kdp1965/ttsky26d-um-lisa-ttlc/fpga/README.md

# LISA on an FPGA

`arty_a7/` puts the chip's RTL (`src/`, unchanged) on a Digilent Arty
A7-35T (XC7A35T) with Vivado, so programs and the debugger can be tried on
the respin's logic before the silicon is back, at speed and with the real
QSPI Pmod.

What differs from the chip:

- The 32x32 RAM is `src/RAM32.v`, the RTL model of the DFFRAM macro
  (the standard-flow RAM; Vivado makes it distributed RAM or flops).
- The sky130 cells `debug_regs.v` and `lisa_dbg.v` instantiate: the
  `and2_4` is an AND (`fpga_cells.v`); the `dlrtp_1` latches of the static
  debug registers (base addresses, the output and I/O muxes, breakpoints)
  are flops.  `latch2flop.py` copies the two files to `gen/` with each
  latch an `fpga_dlrtp` clocked by the module's `clk`, which captures the
  value during the debug write strobe, as the latch does.
- The project clock comes from the board's 100 MHz oscillator through an
  MMCM (`lisa_arty_clk.v`): 1000 MHz / `CLK_DIV`, 20 = 50 MHz (the demo
  board SDK's default), 25 = 40, 15 = 66.67 (the TT07 chip's ceiling);
  `make CLK_DIV=25`.
- Timing: `lisa_arty_mcp.tcl`, sourced after synthesis, is `src/lisa.sdc`'s
  multi-cycle exceptions on the Vivado netlist (the same register groups,
  found by their RTL names; the build log prints the counts).  Two of the
  SDC's groups are not ported (its pre-decode flop, one-hot on the chip,
  and its divider-operand group, which its register walk resolved to the IX
  low byte and the accumulator), and the debugger's step and skip levels are
  in the continue group with cont_q_r, which the SDC's walk of the cont_q
  net missed.  The build is 50 MHz (`CLK_DIV=20`, the demo board's clock)
  since 2026-10-17 with 0.45 ns of setup slack.  What it took, beyond the
  SDC's groups: the window data as a 3-cycle source (which the SDC has
  too, since the same day), and the BF16 adder's cone into the accumulator
  as a 3-cycle path from everything it takes - 29 LUT levels and 21 ns on
  this fabric, two thirds of it routing, 1.3 ns over at first.  The
  accumulator loads only at the end of the execute state (or the stage
  after), and the adder's inputs are all settled three or more clocks
  before: the latched instruction and the decoded operation flags at the
  end of the fetch state (the operand select and gate), the BF16 registers
  and the accumulator at the end of the previous execute state.  The SDC
  covers the first of these on the chip as its one-hot fetch flop to the
  accumulator; here the state register is binary, so that one is applied
  through the stream's core_i_ready net, the select of the instruction
  mux, whose other sources (a breakpoint's stop) it covers as well.  The
  tightest path now is the divider block's registered operand
  classification through the adder into the accumulator (25 levels).
  40 MHz (`CLK_DIV=25`) closes with 1.5 ns and 125000 baud.

Pins (`lisa_arty.v`, `lisa_arty.xdc`): the three Tiny Tapeout ports are
Pmods in the demo board's order (pins 1-4, 7-10 = bits 0-7): JA `ui_in`
(pulled down, as the RP2040 drives them: baud divisor 0, autobaud on), JB
`uo_out`, JC `uio` (the QSPI Pmod; JB and JC are the high-speed Pmods
without series resistors; uio[4] and uio[6], the debugger's other two rx
candidates, are pulled up), JD unused.  The USB-UART is the debug UART:
its rx and JA pin 4 are ANDed into `ui_in[3]` (both idle high), `uo_out[4]`
drives it and JB pin 7.  The RESET button is the reset, held 65536 clocks
after release and after the MMCM locks.  LEDs: LD4 clock locked, LD5 in
reset, LD6 tx, LD7 rx; LD0 (RGB) is the Ethernet: red a frame received,
green one for us, blue one sent.  SW3 up routes the TTLC's I/O to JA / JB
for a real TTLC Pmod; down (the default) it goes to the chains inside the
FPGA, reached over Ethernet (below).

Build: `make -C fpga/arty_a7` where Vivado is on the PATH, or `make -C
fpga/arty_a7 remote` from a machine without it (copies `src/` and the
directory to the clone on `HOST`, andromeda by default, and runs the build
there; `make remote-prog` programs the board on that machine, `make
remote-log` shows the end of its log).  `build/` has the bitstream,
timing, utilization and DRC reports.  `make lint` runs Verilator over the
whole thing without Vivado.  Running a program (2026-10-17, on andromeda with a Tiny Tapeout QSPI Pmod
on JC): `arty_run.py <file.ihx> [seconds]` loads it into the flash through
the debug port (lisa-tools `lisa_pydb`, which reads Intel HEX since then),
reads back the first words, turns the data cache off, runs it, hands it
the UART and prints what it sends.  hello, test_core, test_printf and
test_irq (rev-2 builds) give lisa_sim --rev2's output.  What it takes:

- Any baud rate from 1.5 Mbaud down since RESPIN item 20 (2026-10-17):
  the scripts default to 460800, the demo board's; 115200, 156250 and
  921600 work too.  Before it the autobaud counted in 32-clock steps, so
  a bit had to be a multiple of 32 clocks: 156250 at 50 MHz, 125000 at
  40 (115200 and 460800 did not lock).
- One serial session per run: opening the port resets the design (the
  Arty's JP2 jumper ties the FTDI's DTR to the RESET line), which clears
  the debug registers and halts the core.
- The data cache off (`w1d0007`): with it on, evicted lines go to a PSRAM
  that is not set up (on the chip testbench there is one), so the globals
  read back wrong while the stack, hot in the cache, survives.
- `l` after the resume gives the program the debug UART.
- The QSPI Pmod's uio[7:4] (WP#, HOLD#, the PSRAM selects) are pulled up
  in the XDC; uio[7:4] are undriven until a program sets the mux, and a
  floating HOLD# held the flash.
- `CACHE=1 arty_run.py ...` runs with the data cache on the Pmod's PSRAM A
  (CS1): `psram_mod` (0x1c bit 10, from ttgf-um-lisa) with the uio mux at
  2 (0x1c = 0x4aa), the cache on CS1 (0x15 = 6), on with the 32K map (0x1d
  = 0x13).  hello, test_core, test_printf, test_irq and the two 32K tests
  (test_bigframe, test_ptroff) pass that way; with psram_mod off
  test_bigframe prints nothing.
- Both selects run quad since 2026-10-18 (Ken: the default, as the chip
  testbench and the demo board): 0x17 = 7 with the cache, 5 without (bits
  1:0 quad per select, 3:2 the flash), 0x18 = 0x66 (6 dummy clocks after
  the EB address on each; the Pmod's flash is a W25Q128JV with its QE bit
  set).  `QUAD=0` is the single-SPI flash of before (0x17 = 6 / 4, 0x18 =
  0x6a), `DUMMY=0x..` another count.  Quad reads of the flash needed
  RESPIN item 21 first: the chip floated the bus during the dummy clocks
  and the flash took its mode bits from whatever the lines did, which on
  the Arty put it into continuous-read mode; the engine drives them 1 now
  (the chip has no pull-ups, so the FPGA has none there either).  Quad on
  both: the debug port's read-back exact, hello, test_core and the TTLC
  loopback pass, and lisa_monitor's calc runs 3 to 5 times faster than
  from single-SPI flash - a float32 add 810 us (2720), a bf16 add on the
  FPU 30 us (100), nine of them 190 us (900).  test_core itself takes
  0.05 s from the UART hand-over to ALL PASSED (0.10 single SPI; the
  serial reads are 0.05 s grained): a run's seconds are the load, the
  serial setup and the capture window, which now ends at the first of
  STOP's markers (ALL PASSED / SOME FAILED) and prints the program's time.

## The TTLC's I/O over Ethernet

The TTLC scans its 48 outputs and 48 inputs through three 74HC595 and
three 74HC165 chains on a Pmod (uo_out[2:0] data, uo_out[5] latch,
uo_out[6] shift clock out; ui_in[6:4] in).  On the Arty the chains are
inside the FPGA (`ttlc_chains_fpga.v`, the chip testbench's model made
synchronous: the scan's shift clock is clk/2 at most, so sampling the pins
every clock sees what the chips see), and their two 48-bit registers are
reached from any host on the LAN through the board's Ethernet PHY
(2026-10-17, Ken's choice over a soft processor: the bridge is ~1000 lines
of plain RTL, no toolchain, and the Mac talks to the board directly):

- `eth_mii_mac.v`: a MAC on the DP83848J's MII (4-bit nibbles at 25 MHz,
  the PHY's own RX_CLK and TX_CLK), received frames into two 2 KB buffers
  used in turn, the frame to send in another, each handed between the
  PHY's clock and the project clock by a four-phase handshake - so all
  the protocol logic runs on the project clock.  FCS checked and appended,
  frames padded to 60 bytes, full duplex only.  A frame that arrives
  while both buffers are held is dropped (the host retries); two buffers
  let frames follow each other by the inter-frame gap, since a parse and
  release take ~2 us.
- `eth_ipstack.v`: one address (192.168.1.200, MAC 02:4c:49:53:41:00,
  parameters of `lisa_arty.v`): answers ARP for it, echoes pings, delivers
  UDP datagrams to port 14500 as a byte stream and sends them from it.  A
  parser walks each received frame a byte a clock (the IP header checksum
  summed on the way) and releases it; a builder writes replies into the
  MAC's buffer, with a pass over the IP header for its checksum first,
  waiting for the transmitter while the parser goes on.  No fragments,
  options or gateway; the UDP checksum is sent as zero and not checked.
- `ttlc_eth_app.v`: the commands.  A datagram is a command byte: `I` with
  six little-endian bytes sets the inputs, `R` reads, `S` subscribes the
  sender to an `E` datagram whenever the outputs change (at most one per
  100 us), `U` ends that.  Every datagram is answered with 20 bytes: type
  (`S`, or `E` for an event), flags (bit 0 subscribed, bit 1 SW3, bits
  7:4 the format's version, 1), microseconds since reset, the outputs,
  the inputs, the events sent.
- `eth_ttlc.v` joins the three; `lisa_arty.v` adds the PHY's 25 MHz
  reference clock (the MMCM's second output through an ODDR), its reset
  (from the MMCM's lock only, 26 ms, so the link survives the RESET
  button and the UART's DTR; no MDIO, the PHY autonegotiates from its
  straps) and LD0.  The XDC constrains the two PHY clocks, marks the three
  clocks asynchronous and gives the MII pins the datasheet's delays.

`test/` is the bridge's own testbench (cocotb on Verilator, `make -C
fpga/arty_a7 test`): the PHY's pins driven with frames built in Python
(ARP, pings of several sizes, UDP commands; the wrong MAC, IP, port and
FCS; back-to-back bursts), the chains scanned by the chip's
`shift_reg_io.v`.  On the board, from andromeda or the Mac:

    ping 192.168.1.200
    ttlc_io.py read                      # or: in <hex48>, watch [quiet s], ping
    arty_ttlc.py ../images/ttlc_loopback.hex   # on andromeda, the serial side

`ttlc_io.py` is the client (a class, `TtlcIo`: `read`, `inputs`,
`subscribe`, `events`, the flash methods below, and a command line);
`arty_ttlc.py` loads a TTLC program (readmemh bytes, as the chip
testbench's flash image) into the Pmod's flash at byte 0x10000 through the
debug port, starts the TTLC (0x1f = 0x100, 0x15 = 4, 0x1b = 0x3cff) and
runs the loopback check over Ethernet.

### The flash over Ethernet (2026-10-18)

The debug UART writes the flash a word at a time with a status poll each,
minutes for a big image.  The bridge can take the QSPI Pmod's bus instead:
`X` holds the chip in reset and drives CS, SCLK and MOSI (uio[0], [3],
[1]), reads MISO (uio[2]) and holds uio[7:4] (HOLD#, WP#, the PSRAM
selects) high; `T <bytes>` is one SPI transaction (CS low, the bytes out
in mode 0 at clk/4, CS high), answered with `T` and the bytes read on
MISO, up to 1024 - a page program is one datagram, a read 1020 bytes; `Y`
gives the bus back and the chip restarts (the bridge also gives it back
5 s after the last `X` or `T`, should the host die).  Status flag bit 2
says the bus is held; the format's version is 2.  The bridge testbench's
test_flash runs the sequence against the chip testbench's flash model.

    ttlc_io.py flash id                       # the JEDEC id, through a continuous-read exit
    ttlc_io.py flash write hello_rev2.ihx     # erase, program, verify (an Intel HEX, readmemh bytes or a binary)
    ttlc_io.py flash write ttlc_loopback.hex 10000
    ttlc_io.py flash read 0 64
    ETH=1 CACHE=1 arty_run.py hello_rev2.ihx  # the image over Ethernet, then the debug port only sets up and runs
    ETH=1 arty_ttlc.py ttlc_loopback.hex

`arty_term.py <file.ihx>` is the live terminal: the image over Ethernet,
the debug port's setup with the data cache on (CACHE=0 for the 128-byte
RAM), the program started and given the UART, then pyserial's miniterm on
the same port (ctrl-] quits).  lisa_monitor built with `sdcc -mlisa
--rev2 --stack-loc 0x7fff` (lisa-tools lisa_monitor/monitor_rev2.ihx,
13396 words, 0.3 s to flash) runs on it: Enter for the banner and
`lisa> `, then help, mr, mw, stack, free, calc, banner (2026-10-18).
`SEND='\rhelp'` on arty_run.py scripts the same a line at a time.

`TtlcIo.flash_write(addr, data)` erases the 64 KB blocks the image
covers, programs it page by page, reads it back and releases the bus;
`load_image(path)` gives the bytes (Intel HEX with gaps as zeros, like
the debug loader).  Open the debug port after the Ethernet write: opening
it resets the design, and the flashing resets the chip too (the debug
registers are set up afresh by the scripts).  On the board (2026-10-18):
hello's 860 bytes and test_core's 4264 bytes each erase, program and
verify in 0.25 s, the debug port reads them back with no mismatch, and
test_core's whole run is 10 s where the UART load alone took two minutes;
the TTLC loopback passes loaded the same way (2.3 s end to end).  The
Pmod's flash answers EF 70 18 (Winbond, 128 Mbit).  2026-10-17: `test/progs/ttlc/ttlc_loopback.hex` copies all
seven patterns from the inputs to the outputs on the board (the first TTLC
run outside simulation, the 12-bit slot format fetched from the flash),
`watch` shows an event per change with the board's timestamps, ping
answers in 0.1 ms from the wired host, a UDP round trip is 2.5 ms from
the Mac over wifi.  At 50 MHz (2026-10-17, the exceptions above) the
same checks pass, hello and test_core with the cache on included.

## Code banks (RESPIN 22)

A program with `__banked` functions (`sdcc -mlisa --rev2`, `#pragma bank n`,
linked `-Wl-bBANKn=<n * 0x8000>`: README-lisa.md "Code banks") has code at
flash byte n * 0x8000 and up, as Intel HEX type-04 records; `ttlc_io.py`'s
`load_image`, `lisa_pydb` and `arty_run.py` take them, so `ETH=1
arty_run.py test_bank_rev2.ihx` runs as any other program (14 of 14 on the
board, 2026-10-18, the bitstream with the bank registers at 50 MHz: setup
slack 0.246 ns).  Mind the TTLC convention of `arty_ttlc.py` / the testbench:
a TTLC program at byte 0x10000 sits where code bank 2 lives, so a banked LISA
program and a TTLC program in one flash need the TTLC base register moved up
(0x1f, in 256-byte units; 0x80000 is above all 16 code banks).
