kdp1965/ttsky26d-um-lisa-ttlc/harden/art/calvin/preview.png

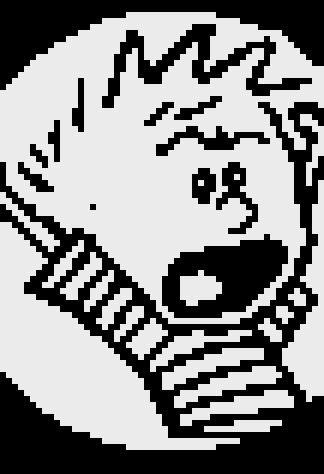
harden/art/calvin/preview.png
