kdp1965/ttsky26d-um-lisa-ttlc/harden/art/calvin/rc4_corner.png

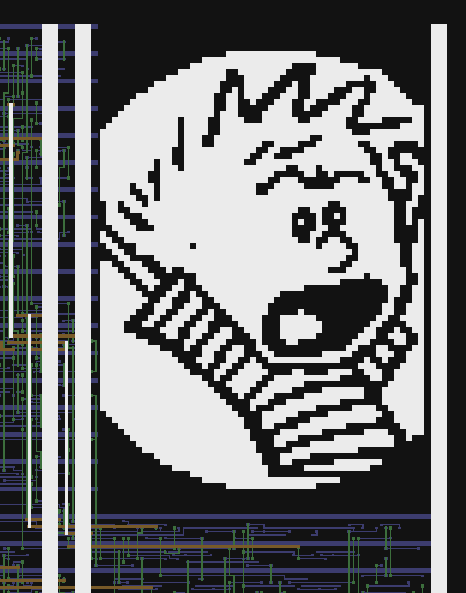
harden/art/calvin/rc4_corner.png
