kdp1965/ttsky26d-um-lisa-ttlc/harden/art/calvin_nocircle/placement_rc18.png

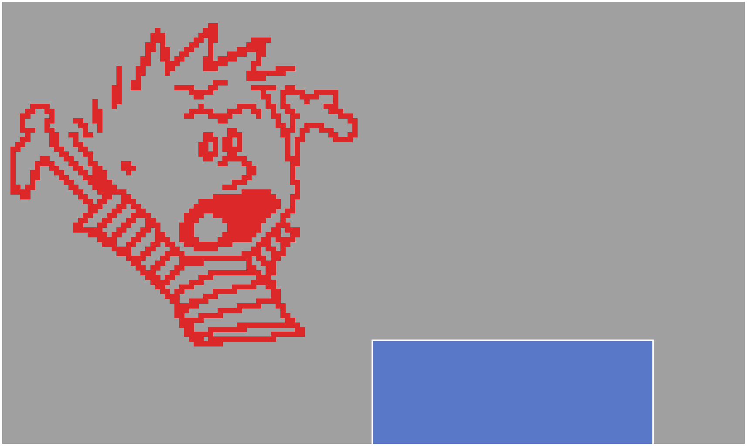
harden/art/calvin_nocircle/placement_rc18.png
