kdp1965/ttsky26d-um-lisa-ttlc/src/lisa_periph.v

/*
==============================================================================
lisa_periph.v:  Little ISA (LISA) peripherals.

Copyright 2024 by Ken Pettit <pettitkd@gmail.com>

Redistribution and use in source and binary forms, with or without
modification, are permitted provided that the following conditions
are met:
1. Redistributions of source code must retain the above copyright
   notice, this list of conditions and the following disclaimer.
2. Redistributions in binary form must reproduce the above copyright
   notice, this list of conditions and the following disclaimer in the
   documentation and/or other materials provided with the distribution.

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
==============================================================================
*/

`define TIMER2
`define WANT_UART2

/*
==========================================================================================
lisa_periph:   A peripheral controller for the lisa core.

Address Map:

   GPIO
   ====
   0x00:       PORT A input
   0x01:       PORT B output
   0x02:       PORT C input / output
   0x03:       PORT C direction (1 = output)
   0x04:       PORT D input   (from TTLC)
   0x05:       PORT E output  (to TTLC)
   0x06:       PORT A INT_CFG0
   0x07:       PORT A INT_CFG1

   TIMER
   =====
   0x08:       Pre Divisor Low
   0x09:       Pre Divisor High
   0x0A:       Divisor Low
   0x0B:       Divisor High
   0x0C:       Control / Status
   0x0D:       Timer tick

   Interrupt
   =========
   0x0E:       Interrupt Enable Register
   0x0F:       Interrupt Status/ACK Register

   UART
   ====
   0x10:       TX/RX register
   0x11:       Status register: bit 0 RX data available, 1 TX buffer empty,
               2 RX overrun (a byte arrived with the 8-byte FIFO full; sticky until it is read empty)
   0x12:       UART2 TX/RX register
   0x13:       UART2 status: bits 0-1 as 0x11, 2 autobaud disable (r/w), 3 RX overrun
   0x1E:       UART2 baud divisor (write): a bit is 32 x (d + 1) clocks
   0x14:       UART interrupt enables

   BANKS (revision 2, RESPIN 22)
   =============================
   0x15:       Code bank  [5:0]: fetches above word 0x4000             (reset 1)
   0x16:       Data bank  [3:0]: IX-relative and debugger accesses above 0x4000 (reset 1)
   0x17:       Stack bank [3:0]: SP-relative accesses above 0x4000     (reset 1)

   TIMER2
   =====
   0x18:       Pre Divisor Low
   0x19:       Pre Divisor High
   0x1A:       Divisor Low
   0x1B:       Divisor High
   0x1C:       Control / Status
   0x1D:       Timer tick

   I2C
   ====
   0x20:       CLOCK PRE div LSB register
   0x21:       CLOCK PRE div MSB register
   0x22:       CTRL
   0x23:       RX
   0x24:       STATUS
   0x25:       TX
   0x26:       CMD

   SPI (RESPIN 29, lisa_spi.v)
   ===
   0x28:       DATA: write sends a byte, read the byte received
   0x29:       CTRL: CS0, CS1, CPOL, CPHA, CLAIM, MISO select [6:5], IE
   0x2A:       DIV: half an SCLK period is DIV + 1 clocks
   0x2B:       STATUS: BUSY, DONE, OWNED, TTLC_WAIT

   TIMER3 (RESPIN 32, lisa_timer3.v): interrupt source 8, vector 9
   ======
   0x30:       PRE: a tick every PRE + 1 clocks
   0x31-0x32:  TOP: the counter runs 0..TOP (reset 0xFFFF)
   0x33-0x34:  CNT (reading the low byte latches the high; a write to the
               low byte loads {the high byte written before, it})
   0x35-0x38:  CMP0, CMP1: PWM0 / PWM1 high while CNT < CMPn
   0x39-0x3C:  CAP0, CAP1: CNT at an edge of ui_in[4] / ui_in[5]
   0x3D:       CTRL: [0] EN, [2:1] PWM1 / PWM0 out, [5:4] CAP0 edge, [7:6] CAP1 edge
   0x3E:       IE: OVF, CMP0, CMP1, CAP0, CAP1; [6:5] PDM0 / PDM1 (RESPIN 36):
               the channel a sigma-delta output of CMPn[7:0] / 256 (CAPn its
               accumulator) instead of an input capture
   0x3F:       STATUS: the same, a 1 written clears

   WS2812B (RESPIN 33, lisa_ws2812.v): the pixels in the TTLC's output flops
   =======
   0x40:       WS_CTRL: [0] EN, [3:1] PIN (uo[0], [1], [2], [5], [6]), [4] IE
   0x41:       WS_STAT: FULL_A, FULL_B, BUSY, DONE, UNDERRUN, NEXT; write sets FULL
   0x42-0x45:  WS_T0H, WS_T1H, WS_TBIT, WS_TRST: the timing in clocks

   CYCLE COUNTER, WATCHDOG (RESPIN 36: lisa_cyccnt.v, lisa_wdt.v; the PDM
   outputs are Timer 3's channels in PDM mode, IE [6:5])
   =============================
   0x48-0x4B:  CYC0..CYC3: a 32-bit count of clocks (a CYC0 read latches 1..3,
               a write to CYC0 clears it)
   0x4C:       WDT_CTRL: [0] EN, [3:1] SCALE
   0x4D:       WDT_KICK: 0xA5 written restarts the count; read: the ticks
   0x4E:       WDT_TIMEOUT: (TIMEOUT + 1) x 2^(16 + SCALE) clocks (reset 255)
   0x4F:       WDT_STAT: [0] WDRST, the last reset was the watchdog's (1 clears)

   TTLC I/O (RESPIN 30, lisa_ttlcio.v)
   ========
   0x2C:       TIDX: the byte of the TTLC's I/O vector, 0-23
   0x2D:       TDATA: byte TIDX (outputs 0-5, inputs 6-11, storage 12-15,
               port_in 16, {RR, 0, 1} 17, 0 18-19, storage 20-23 - RESPIN 31);
               writes to 0-5, 12-15 and 20-23; TIDX + 1
   0x2E:       TCTRL: write [0] START a scan; read BUSY, DONE, PEND, TTLC_WAIT, OWNED

==========================================================================================
*/
module lisa_periph
(
   input                clk,
   input                rst_n,               // includes the watchdog's reset (RESPIN 36)
   input                rst_por_n,           // without it: the watchdog's own
`ifdef WANT_UART2
   input                rst_async_n,
`endif

   // UART access
   input  [6:0]         d_addr,
   input  [7:0]         d_i,
   input                d_periph,
   input                d_we,
   input                d_rd,
   output wire [7:0]    d_o,

   // GPIO
   input  wire [7:0]    porta_in,
   output reg  [7:0]    portb,
   output reg  [3:0]    portc,
   input  wire [3:0]    portc_in,
   output reg  [3:0]    portc_dir,
   input  wire [7:0]    portd_in,
   output reg  [7:0]    porte,

   // The code bank register (RESPIN 22, REV3.md): 7 bits, 128 code banks of
   // 16K words; the core writes it on a jump through IX or a return
   output reg  [6:0]    code_bank,
   input  wire          cb_we,
   input  wire [6:0]    cb_val,

   output wire [8:0]    int_o,               // bit 8: Timer 3 (RESPIN 32), gated by its own IE
   output reg  [7:0]    int_en,
   input  wire          ttlc_int,

   // UART
   output wire [7:0]    uart_tx_d,
   output wire          uart_tx_wr,
   output wire          uart_rx_rd,
   input  wire [7:0]    uart_rx_d,
   input  wire          uart_rx_data_avail,
   input  wire          uart_tx_buf_empty,
   input  wire          uart_rx_overrun,

`ifdef WANT_UART2
   // UART 2
   input  wire          uart2_rx,
   output wire          uart2_tx,
`endif

   // I2C
   input  wire          scl_pad_i,
   output wire          scl_pad_o,
   output wire          scl_padoen_o,
   input  wire          sda_pad_i,
   output wire          sda_pad_o,
   output wire          sda_padoen_o,

   // SPI (RESPIN 29, lisa_spi.v)
   input  wire [3:0]    spi_miso_in,         // {ui_in[7], ui_in[2:0]}
   output wire          spi_sclk,
   output wire          spi_sclk_m3,         // SCLK on the TTLC's pins (moves only while owned)
   output wire          spi_mosi,
   output wire [1:0]    spi_cs_n,
   input  wire          ttlc_scan_req,       // the TTLC wants a scan
   input  wire          ttlc_scan_busy,      // a scan in progress
   output wire          spi_owned,           // the TTLC's mode-3 pins are the SPI's

   // The TTLC's I/O as bytes (RESPIN 30, lisa_ttlcio.v)
   output wire [4:0]    ttlc_idx,
   output wire [7:0]    ttlc_wdata,
   output wire          ttlc_we,
   input  wire [7:0]    ttlc_rdata,
   output wire          ttlc_lisa_start,     // a scan the core started

   // Timer 3 (RESPIN 32, lisa_timer3.v)
   input  wire [1:0]    t3_cap_in,           // ui_in[5:4]
   output wire [1:0]    t3_pwm,              // Timer 3's PWM (or its PDM outputs, RESPIN 36)
   output wire [1:0]    t3_pwm_oe,

   // WS2812B driver (RESPIN 33, lisa_ws2812.v)
   input  wire [47:0]   ws_pixels,           // the TTLC's output_pins: two pixels
   output wire          ws_en,               // WS mode: mux 3's TTLC pins
   output wire [4:0]    ws_pins,             // uo[6], uo[5], uo[2], uo[1], uo[0]
   // ... its DMA through the TTLC's fetch (RESPIN 35)
   input  wire [47:0]   ws_grp,
   input  wire          ws_grp_valid,
   input  wire          ws_fetch_idle,
   input  wire          ws_flush_ack,
   output wire          ws_flush_req,
   output wire          ws_dma_fetch,
   output wire          ws_restart,
   output wire          ws_adv,
   output wire [11:0]   ws_last_grp,
   output wire [15:0]   ws_base,

   // The watchdog (RESPIN 36, lisa_wdt.v): resets the core and the peripherals
   output wire          wdt_reset
);

   reg   [15:0]         ms_count;
   reg   [15:0]         ms_prediv;
   reg   [15:0]         ms_preload;
   reg   [15:0]         ms_timer;
   reg   [7:0]          ms_tick;
   reg                  ms_enable;
   reg                  ms_rollover;
   reg                  uart_tx_ie;
   reg                  uart_rx_ie;
   wire                 uart_req;            // the UART1 request: a level (RESPIN 25)
   wire                 uart2_req;
   
   reg   [5:0]          int_o_r;             // the latched requests (bits 2 / 3 unused: the UARTs are levels)
   wire  [5:0]          int_req;
   reg   [7:0]          porta_last;
   reg   [7:0]          porta_int0;
   reg   [7:0]          porta_int1;
   wire  [1:0]          porta_int_mode[7:0];
   reg   [7:0]          porta_int;
   reg                  ttlc_int_last;

`ifdef TIMER2
   reg   [15:0]         ms2_count;
   reg   [15:0]         ms2_prediv;
   reg   [15:0]         ms2_preload;
   reg   [15:0]         ms2_timer;
   reg   [7:0]          ms2_tick;
   reg                  ms2_enable;
   reg                  ms2_rollover;
`endif

   wire  [3:0]          portc_read;
   reg   [7:0]          d_o_r;
   wire  [7:0]          i2c_d_o;
   wire                 sda_oen_n;
   wire                 scl_oen_n;
   wire                 i2c_irq;
   wire  [7:0]          spi_d_o;
   wire  [7:0]          ttlcio_d_o;
   wire  [7:0]          t3_d_o;
   wire  [7:0]          ws_d_o;
   wire  [7:0]          cyc_d_o;             // RESPIN 36: the cycle counter, the watchdog
   wire  [7:0]          wdt_d_o;
   wire                 ws_ie;
   wire                 ws_irq;
   wire                 t3_irq;
   wire                 spi_xfer_busy;
   wire                 spi_irq;

`ifdef WANT_UART2
   // UART
   wire [7:0]    uart2_tx_d;
   wire          uart2_tx_wr;
   wire          uart2_rx_rd;
   wire [7:0]    uart2_rx_d;
   wire          uart2_rx_data_avail;
   wire          uart2_tx_buf_empty;
   wire          uart2_rx_overrun;
   wire          uart2_brg_wr;
   wire [7:0]    uart2_brg_d;
   reg           uart2_autobaud_disable;
   reg           uart2_tx_ie;
   reg           uart2_rx_ie;
`endif

   // 0x2E's TTLC_WAIT bit, a clock late: ttlc_scan_req is the ICU's FLAG_O,
   // a falling-edge flop, and read through d_o it was a half-clock path into
   // the core (RESPIN 38)
   reg           ttlc_wait_r;
   always @(posedge clk)
      ttlc_wait_r <= rst_n && ttlc_scan_req && spi_owned;

   always @(posedge clk)
   begin
      if (~rst_n)
      begin
         porta_last   <= 8'h00;
         porta_int0   <= 8'h00;
         porta_int1   <= 8'h00;
         portb        <= 8'h00;
         portc        <= 4'h00;
         porte        <= 8'h00;
         portc_dir    <= 4'h0;
         code_bank    <= 7'h1;
         ms_prediv    <= 16'd29494;
         ms_count     <= 16'h0;
         ms_timer     <= 16'h0;
         ms_preload   <= 16'h0;
         ms_tick      <= 8'h0;
         ms_enable    <= 1'h0;
         ms_rollover  <= 1'b0;
         int_o_r      <= 6'h0;
         int_en       <= 8'h0;
         uart_tx_ie   <= 1'b0;
         uart_rx_ie   <= 1'b0;

`ifdef TIMER2
         ms2_prediv   <= 16'd29494;
         ms2_count    <= 16'h0;
         ms2_timer    <= 16'h0;
         ms2_preload  <= 16'h0;
         ms2_tick     <= 8'h0;
         ms2_enable   <= 1'h0;
         ms2_rollover <= 1'b0;
`endif
`ifdef WANT_UART2
         uart2_autobaud_disable <= 1'b0;
         uart2_tx_ie  <= 1'b0;
         uart2_rx_ie  <= 1'b0;
`endif
      end
      else
      begin
         porta_last <= porta_in;
         ttlc_int_last <= ttlc_int;

         // ==============================================
         // GPIO signals
         // ==============================================
         // Latch input data as PORTB
         if (d_periph && d_we && d_addr == 7'h01)
            portb <= d_i;

         // Latch input data as PORTC
         if (d_periph && d_we && d_addr == 7'h02)
            portc <= d_i[3:0];

         // Latch input data as PORTC_DIR
         if (d_periph && d_we && d_addr == 7'h03)
            portc_dir <= d_i[3:0];

         // Latch porte
         if (d_periph && d_we && d_addr == 7'h05)
            porte <= d_i;

         // The code bank: fetches above word 0x4000 come from it.  1 = the
         // upper half as the TT07 chip had it, so an image that never writes
         // it runs as before.  call ix / jmp ix / ret / rets set it from the
         // pointer or the return address (REV3.md); the data and stack banks
         // and KB of revision 2 (0x16, 0x17, 0x1F) are gone: the data space
         // is flat and lda (ix++) carries its bank in IX
         if (cb_we)
            code_bank <= cb_val;
         else if (d_periph && d_we && d_addr == 7'h15)
            code_bank <= d_i[6:0];

         // Latch porta_int0
         if (d_periph && d_we && d_addr == 7'h06)
            porta_int0 <= d_i;

         // Latch porta_int1
         if (d_periph && d_we && d_addr == 7'h07)
            porta_int1 <= d_i;

         // GPIO Interrupt
         if (|porta_int)
            int_o_r[4] <= 1'b1;
         else if (d_periph && d_we && d_addr == 7'h0F && d_i[4])
            int_o_r[4] <= 1'b0;

         // TTLC Interrupt
         if (ttlc_int ^ ttlc_int_last)
            int_o_r[5] <= 1'b1;
         else if (d_periph && d_we && d_addr == 7'h0F && d_i[5])
            int_o_r[5] <= 1'b0;

         // ==============================================
         // Interrupt enable
         // ==============================================
         if (d_periph && d_we && d_addr == 7'h0E)
            int_en <= d_i;

         // The UART interrupt enables, 0x14: bit 0 UART1 receive, 1 UART1
         // transmit, 2 / 3 UART2 (RESPIN 25: neither chip's RTL wrote these
         // flops - they read back 0 and no UART interrupt ever fired)
         if (d_periph && d_we && d_addr == 7'h14)
         begin
            uart_rx_ie <= d_i[0];
            uart_tx_ie <= d_i[1];
`ifdef WANT_UART2
            uart2_rx_ie <= d_i[2];
            uart2_tx_ie <= d_i[3];
`endif
         end

         // ==============================================
         // Timer signals
         // ==============================================
         // The control signal
         if (d_periph && d_we && d_addr == 7'h0C)
            ms_enable <= d_i[0];

         // The pre divider
         if (d_periph && d_we && d_addr == 7'h08)
            ms_prediv[7:0] <= d_i;

         // The pre divider
         if (d_periph && d_we && d_addr == 7'h09)
            ms_prediv[15:8] <= d_i;

         // The preload
         if (d_periph && d_we && d_addr == 7'h0A)
            ms_preload[7:0] <= d_i;

         // The preload
         if (d_periph && d_we && d_addr == 7'h0B)
            ms_preload[15:8] <= d_i;

         // The ms_rollover bit
         if (d_periph && 
                ((d_rd && d_addr == 7'h0C) ||
                 (d_we && d_addr == 7'h0D)))
            ms_rollover <= 1'b0;
         else if (ms_count == ms_prediv && ms_timer == 16'h01)
         begin
            ms_rollover <= 1'b1;
            int_o_r[0] <= 1'b1;
         end
         else if (d_periph && d_we && d_addr == 7'h0F && d_i[0])
            int_o_r[0] <= 1'b0;

         // Loading tick value also resets 1ms timimg
         if (d_periph && d_we && d_addr == 7'h0D)
         begin
            ms_tick <= d_i;
            ms_timer <= ms_preload;
            ms_count <= 16'h0; 
         end

         // Test if timer is enabled
         else if (ms_enable)
         begin
            // Implement a 1ms tick
            if (ms_count == ms_prediv)
            begin
               ms_count <= 16'h0; 
            
               // Count down to 1 then increment tick and load the preload
               if (ms_timer == 16'h01)
               begin
                  ms_tick <= ms_tick + 1;
                  ms_timer <= ms_preload;
               end
               else
                  ms_timer <= ms_timer - 1;
            end
            else
               ms_count <= ms_count + 16'h1;
         end
         else
         begin
            ms_tick <= 8'h0;
            ms_timer <= ms_preload;
            ms_count <= 16'h0; 
         end

         // The UART1 request is a level (uart_req below): no latch, nothing
         // to acknowledge in INT_STATUS

`ifdef TIMER2
         // ==============================================
         // Timer2 signals
         // ==============================================
         // The control signal
         if (d_periph && d_we && d_addr == 7'h1C)
            ms2_enable <= d_i[0];

         // The pre divider
         if (d_periph && d_we && d_addr == 7'h18)
            ms2_prediv[7:0] <= d_i;

         // The pre divider
         if (d_periph && d_we && d_addr == 7'h19)
            ms2_prediv[15:8] <= d_i;

         // The preload
         if (d_periph && d_we && d_addr == 7'h1A)
            ms2_preload[7:0] <= d_i;

         // The preload
         if (d_periph && d_we && d_addr == 7'h1B)
            ms2_preload[15:8] <= d_i;

         // The ms2_rollover bit
         if (d_periph && 
                ((d_rd && d_addr == 7'h1C) ||
                 (d_we && d_addr == 7'h1D)))
            ms2_rollover <= 1'b0;
         else if (ms2_count == ms2_prediv && ms2_timer == 16'h01)
         begin
            ms2_rollover <= 1'b1;
            int_o_r[1] <= 1'b1;
         end
         else if (d_periph && d_we && d_addr == 7'h0F && d_i[1])
            int_o_r[1] <= 1'b0;

         // Loading tick value also resets 1ms timimg
         if (d_periph && d_we && d_addr == 7'h1D)
         begin
            ms2_tick <= d_i;
            ms2_timer <= ms2_preload;
            ms2_count <= 16'h0; 
         end

         // Test if timer is enabled
         else if (ms2_enable)
         begin
            // Implement a 1ms tick
            if (ms2_count == ms2_prediv)
            begin
               ms2_count <= 16'h0; 
            
               // Count down to 1 then increment tick and load the preload
               if (ms2_timer == 16'h01)
               begin
                  ms2_tick <= ms2_tick + 1;
                  ms2_timer <= ms2_preload;
               end
               else
                  ms2_timer <= ms2_timer - 1;
            end
            else
               ms2_count <= ms2_count + 16'h1;
         end
         else
         begin
            ms2_tick <= 8'h0;
            ms2_timer <= ms2_preload;
            ms2_count <= 16'h0; 
         end
`endif
`ifdef WANT_UART2
         // UART2 autobaud disable
         if (d_periph && d_we && d_addr == 7'h13)
            uart2_autobaud_disable <= d_i[2];

`endif
      end
   end

   // ==============================================
   // The read signals
   // ==============================================
   generate
   genvar x;
   for (x = 0; x < 4; x = x + 1)
   begin : GEN_READ
      assign portc_read[x] = portc_dir[x] ? portc[x] : portc_in[x];
   end

   // PORTA interrupt signals
   for (x = 0; x < 8; x = x + 1)
   begin : GEN_INT
      assign porta_int_mode[x][0] = porta_int0[x];
      assign porta_int_mode[x][1] = porta_int1[x];

      always @*
      case (porta_int_mode[x])
      2'h0: porta_int[x] = 1'b0;
      2'h1: porta_int[x] = porta_in[x];
      2'h2: porta_int[x] = porta_in[x] & !porta_last[x];
      2'h3: porta_int[x] = ~porta_in[x] & porta_last[x];
      endcase
   end
   endgenerate 

   always @*
   begin
      case (d_addr)
      // GPIO readback
      7'h00:   d_o_r = porta_in;
      7'h01:   d_o_r = portb;
      7'h02:   d_o_r = {4'h0, portc_read};
      7'h03:   d_o_r = {4'h0, portc_dir};
      7'h04:   d_o_r = portd_in;
      7'h05:   d_o_r = porte;
      7'h06:   d_o_r = porta_int0;
      7'h07:   d_o_r = porta_int1;

      // Timer readback
      7'h08:   d_o_r = ms_prediv[7:0];
      7'h09:   d_o_r = ms_prediv[15:8];
      7'h0A:   d_o_r = ms_preload[7:0];
      7'h0B:   d_o_r = ms_preload[15:8];
      7'h0C:   d_o_r = { ms_rollover, 6'h0, ms_enable};
      7'h0D:   d_o_r = ms_tick;

      // Int EN readback
      7'h0E:   d_o_r = int_en;
      7'h0F:   d_o_r = {spi_irq, i2c_irq, int_req};

      // UART read
      7'h10:   d_o_r = uart_rx_d;
      // bit 2 (RESPIN 14): a byte arrived with the 8-byte receive FIFO full;
      // clears when the FIFO has been read empty
      7'h11:   d_o_r = {5'h0, uart_rx_overrun, uart_tx_buf_empty, uart_rx_data_avail};

`ifdef WANT_UART2
      // UART2 read
      7'h12:   d_o_r = uart2_rx_d;
      7'h13:   d_o_r = {4'h0, uart2_rx_overrun, uart2_autobaud_disable, uart2_tx_buf_empty, uart2_rx_data_avail};
      7'h14:   d_o_r = {4'h0, uart2_tx_ie, uart2_rx_ie, uart_tx_ie, uart_rx_ie};
`else
      7'h14:   d_o_r = {6'h0, uart_tx_ie, uart_rx_ie};
`endif

      // The code bank register
      7'h15:   d_o_r = {1'h0, code_bank};

      // Timer2 readback
`ifdef TIMER2
      7'h18:   d_o_r = ms2_prediv[7:0];
      7'h19:   d_o_r = ms2_prediv[15:8];
      7'h1A:   d_o_r = ms2_preload[7:0];
      7'h1B:   d_o_r = ms2_preload[15:8];
      7'h1C:   d_o_r = { ms2_rollover, 6'h0, ms2_enable};
      7'h1D:   d_o_r = ms2_tick;
`endif

      default: d_o_r = 8'h00;
      endcase
   end

   // ==============================================
   // UART read / write controls
   // ==============================================
   // d_rd is the core's read strobe (lda, swapi: RESPIN 23 - on TT07 a store's
   // exec clock pulsed it too, and a putc to 0x10 popped a received byte)
   assign uart_tx_wr = d_periph && d_we && d_addr == 7'h10;
   assign uart_rx_rd = d_periph && d_rd && d_addr == 7'h10;
   assign uart_tx_d  = d_i;

`ifdef WANT_UART2
   assign uart2_tx_wr = d_periph && d_we && d_addr == 7'h12;
   assign uart2_rx_rd = d_periph && d_rd && d_addr == 7'h12;
   assign uart2_tx_d  = d_i;
   // UART2's baud divisor: a bit is 32 x (d + 1) clocks (as the debug BRG);
   // it was written by any access to 0x14, the interrupt enables (RESPIN 23)
   assign uart2_brg_wr= d_periph && d_we && d_addr == 7'h1E;
   assign uart2_brg_d = d_i;
`endif

   // ==============================================
   // Instantiate I2C master
   // ==============================================
   lisa_i2c i_lisa_i2c
   (
      .clk          ( clk          ),
      .rst_n        ( rst_n        ),
      .d_addr       ( d_addr       ),
      .d_i          ( d_i          ),
      .d_periph     ( d_periph     ),
      .d_we         ( d_we         ),
      .d_o          ( i2c_d_o      ),
      .scl_pad_i    ( scl_pad_i    ),
      .scl_pad_o    ( scl_pad_o    ),
      .scl_padoen_o ( scl_oen_n    ),
      .sda_pad_i    ( sda_pad_i    ),
      .sda_pad_o    ( sda_pad_o    ),
      .sda_padoen_o ( sda_oen_n    ),
      .irq_flag     ( i2c_irq      )
   );
   assign scl_padoen_o  = ~scl_oen_n;
   assign sda_padoen_o  = ~sda_oen_n;

   // ==============================================
   // Instantiate the SPI master (RESPIN 29)
   // ==============================================
   lisa_spi i_lisa_spi
   (
      .clk          ( clk            ),
      .rst_n        ( rst_n          ),
      .d_addr       ( d_addr         ),
      .d_i          ( d_i            ),
      .d_periph     ( d_periph       ),
      .d_we         ( d_we           ),
      .d_rd         ( d_rd           ),
      .d_o          ( spi_d_o        ),
      .miso_in      ( spi_miso_in    ),
      .sclk         ( spi_sclk       ),
      .sclk_m3      ( spi_sclk_m3    ),
      .mosi         ( spi_mosi       ),
      .cs_n         ( spi_cs_n       ),
      .scan_req     ( ttlc_scan_req  ),
      .scan_busy    ( ttlc_scan_busy ),
      .owned        ( spi_owned      ),
      .xfer_busy    ( spi_xfer_busy  ),
      .irq          ( spi_irq        )
   );

   // ==============================================
   // The TTLC's I/O for the core (RESPIN 30)
   // ==============================================
   lisa_ttlcio i_lisa_ttlcio
   (
      .clk          ( clk             ),
      .rst_n        ( rst_n           ),
      .d_addr       ( d_addr          ),
      .d_i          ( d_i             ),
      .d_periph     ( d_periph        ),
      .d_we         ( d_we            ),
      .d_rd         ( d_rd            ),
      .d_o          ( ttlcio_d_o      ),
      .idx          ( ttlc_idx        ),
      .wdata        ( ttlc_wdata      ),
      .we           ( ttlc_we         ),
      .rdata        ( ttlc_rdata      ),
      .scan_busy    ( ttlc_scan_busy  ),
      .spi_busy     ( spi_xfer_busy   ),
      .ttlc_wait    ( ttlc_wait_r     ),     // read-only status: a clock late (RESPIN 38)
      .owned        ( spi_owned       ),
      .start        ( ttlc_lisa_start )
   );

   // ==============================================
   // Timer 3: PWM and input capture (RESPIN 32)
   // ==============================================
   lisa_timer3 i_lisa_timer3
   (
      .clk          ( clk             ),
      .rst_n        ( rst_n           ),
      .d_addr       ( d_addr          ),
      .d_i          ( d_i             ),
      .d_periph     ( d_periph        ),
      .d_we         ( d_we            ),
      .d_rd         ( d_rd            ),
      .d_o          ( t3_d_o          ),
      .cap_in       ( t3_cap_in       ),
      .pwm          ( t3_pwm          ),
      .pwm_oe       ( t3_pwm_oe       ),
      .irq          ( t3_irq          )
   );

   // ==============================================
   // WS2812B driver (RESPIN 33)
   // ==============================================
   lisa_ws2812 i_lisa_ws2812
   (
      .clk          ( clk             ),
      .rst_n        ( rst_n           ),
      .d_addr       ( d_addr          ),
      .d_i          ( d_i             ),
      .d_periph     ( d_periph        ),
      .d_we         ( d_we            ),
      .d_o          ( ws_d_o          ),
      .pixels       ( ws_pixels       ),
      .grp          ( ws_grp          ),
      .grp_valid    ( ws_grp_valid    ),
      .fetch_idle   ( ws_fetch_idle   ),
      .flush_ack    ( ws_flush_ack    ),
      .flush_req    ( ws_flush_req    ),
      .dma_fetch    ( ws_dma_fetch    ),
      .restart      ( ws_restart      ),
      .adv          ( ws_adv          ),
      .last_grp     ( ws_last_grp     ),
      .base         ( ws_base         ),
      .en           ( ws_en           ),
      .pins         ( ws_pins         ),
      .ie           ( ws_ie           ),
      .irq          ( ws_irq          )
   );

   // ==============================================
   // The cycle counter and the watchdog (RESPIN 36; the PDM outputs are
   // Timer 3's channels in PDM mode)
   // ==============================================
   lisa_cyccnt i_lisa_cyccnt
   (
      .clk          ( clk             ),
      .rst_n        ( rst_n           ),
      .d_addr       ( d_addr          ),
      .d_i          ( d_i             ),
      .d_periph     ( d_periph        ),
      .d_we         ( d_we            ),
      .d_rd         ( d_rd            ),
      .d_o          ( cyc_d_o         )
   );

   lisa_wdt i_lisa_wdt
   (
      .clk          ( clk             ),
      .rst_n        ( rst_por_n       ),
      .d_addr       ( d_addr          ),
      .d_i          ( d_i             ),
      .d_periph     ( d_periph        ),
      .d_we         ( d_we            ),
      .d_o          ( wdt_d_o         ),
      .wdt_reset    ( wdt_reset       )
   );

   assign d_o = d_o_r | i2c_d_o | spi_d_o | ttlcio_d_o | t3_d_o | ws_d_o | cyc_d_o | wdt_d_o;
   // The requests to the core and INT_STATUS.  The timers' rollovers, the
   // port's edges and the TTLC's toggle are instants: latched (int_o_r) until
   // a 1 is written to their bit of INT_STATUS.  The UARTs' are states - a
   // byte waits, the transmitter is empty - and the request is that state
   // while its enable (0x14) is set: a byte already waiting when the enable
   // is set interrupts at once, a second byte queued behind an unread one
   // keeps the request up, the handler ends it by draining the FIFO, writing
   // the next byte or dropping the enable; a write to bits 2 / 3 of
   // INT_STATUS does nothing (RESPIN 25, Ken's decision of 2026-10-18;
   // until then an edge was latched - and the enables had no write decode).
   assign uart_req  = (uart_rx_data_avail & uart_rx_ie) | (uart_tx_buf_empty & uart_tx_ie);
`ifdef WANT_UART2
   assign uart2_req = (uart2_rx_data_avail & uart2_rx_ie) | (uart2_tx_buf_empty & uart2_tx_ie);
`else
   assign uart2_req = 1'b0;
`endif
   // source 5 is the TTLC's toggle, or the WS2812B driver's free half while
   // its IE is set (RESPIN 33: the TTLC's I/O is not in use then)
   assign int_req = {ws_ie ? ws_irq : int_o_r[5], int_o_r[4], uart2_req, uart_req, int_o_r[1:0]};
   assign int_o   = {t3_irq, spi_irq, i2c_irq, int_req};

`ifdef WANT_UART2
   lisa_uart i_lisa_uart_2
   (
      .clk              ( clk                    ),
      .rst_n            ( rst_n                  ),
      .rst_async_n      ( rst_async_n            ),
      .rx               ( uart2_rx               ),
      .tx               ( uart2_tx               ),
      .tx_d             ( uart2_tx_d             ),
      .tx_wr            ( uart2_tx_wr            ),
      .rx_rd            ( uart2_rx_rd            ),
      .rx_d             ( uart2_rx_d             ),
      .rx_data_avail    ( uart2_rx_data_avail    ),
      .tx_buf_empty     ( uart2_tx_buf_empty     ),
      .rx_overrun       ( uart2_rx_overrun       ),
      .brg_wr           ( uart2_brg_wr           ),
      .brg_d            ( uart2_brg_d            ),
      .autobaud_disable ( uart2_autobaud_disable )
   );
`endif
endmodule
