kdp1965/ttsky26d-um-lisa-ttlc/(commit log)

2026-10-17 .github/workflows: the Tiny Tapeout actions at the ttsky26d tag, the shuttle this project is going on (the repo had been created from the ttsky26c template, hence its old name). Against ttsky26c the 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
2026-10-17 fpga/arty_a7: the chip's RTL on a Digilent Arty A7-35T with Vivado (non-project Tcl flow, buildable remotely: make remote / remote-prog). RAM32 is its RTL model, the sky130 dlrtp latches of debug_reg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
2026-10-17 psram_mod (RESPIN.md item 18, from ttgf-um-lisa): register 0x1c bit 10 maps the data cache's quad SPI onto the Tiny Tapeout QSPI Pmod - with the uio mux at 2, SIO2 / SIO3 on uio[4:5], CE1 on uio[6], 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
2026-10-17 fpga/arty_a7: programs run on the board. The QSPI Pmod's uio[7:4] (WP#, HOLD#, the PSRAM selects) are pulled up - undriven until a program sets the mux, a floating HOLD# held the flash. arty_run.py l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
2026-10-18 fpga/arty_a7: arty_run.py CACHE=1 runs with the data cache on the Tiny Tapeout QSPI Pmod's PSRAM A through psram_mod (0x1c = 0x4aa, CS1 quad with 6 dummy clocks, the flash single SPI, the cache on CS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
2026-10-18 TTLC program format (RESPIN.md item 19, Ken's design): 12-bit instructions {address[7:0], opcode[3:0]}, four to a group of three 16-bit words; jmp takes two slots, the second its 12-bit target group;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
2026-10-18 fpga/arty_a7: the TTLC's I/O over the Arty's Ethernet - the 74HC595/165 chains inside the FPGA (ttlc_chains_fpga.v, the testbench's model made synchronous; SW3 up gives JA/JB to a real TTLC Pmod) and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
2026-10-18 fpga/arty_a7: 50 MHz, the demo board's clock (Ken, 2026-10-17; the default was 40). The 50 MHz build failed by 1.3 ns on the BF16 adder's cone into the accumulator - 29 LUT levels, 21 ns, two thirds 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
2026-10-18 RESPIN 20: the debug UART's autobaud and baud rate generator count in clocks, not 32s (Ken, 2026-10-17: "improve the autobaud so it doesn't count in multiples of 32 clocks", found on the Arty where 1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
2026-10-18 RESPIN 20, the program UART: lisa_uart.v instantiates the same autobaud and generator for LISA's UART and ORed the CPU's 8-bit divisor write with the autobaud's result into the generator's data, so i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
2026-10-18 harden: Ken's calvin chip art on the LISA tile (2026-10-18) - chip_art.py (prism's tool for sky130A: met4 71/20, sky130A_mr.drc's met4 rules met on the 0.6 um pixel grid, m4.11's 10 um width by a slo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
2026-10-18 fpga/arty_a7: the flash over Ethernet (Ken, 2026-10-18: the debug UART's word-at-a-time load takes minutes). The bridge takes the QSPI Pmod's bus on X - the chip held in reset, JC driven by an SPI en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
2026-10-18 fpga/README.md: the flash over Ethernet on the board - 0.25 s for test_core's 4264 bytes (erase, program, verify), the whole run 10 s against the UART load's two minutes; hello, test_core and the TTL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
2026-10-18 harden/chip_art.py: Magic's met4.5a fails where thin metal leaves a convex corner of a 3 um body on both sides (the two pieces of the 0.4 um band around the body meet at the corner point, zero spacin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
2026-10-18 RESPIN.md: rc4 (runs/macro-rc4-art, the art, a free draw) - routed clean, 790K um of wire against rc3's 913K, Magic DRC / LVS / antenna 0 after the met4.5a corner fix; the corner of the GDS rendered 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
2026-10-18 harden: calvin without the slot rows (Ken saw the five empty rows): the picture's strokes leave no white area 10 um wide both ways, the m4.11 self-check passes with no slots, and neither the precheck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
2026-10-18 harden/flow.py: merge_art prunes an existing art cell first (a resume from Project.ChipArt had stacked a second one, KLayout naming it $1); rc4's tail redone from Magic.StreamOut with the slot-free p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
2026-10-18 fpga/arty_a7: arty_term.py, a live terminal on a program on the Arty (the image over Ethernet, the debug port's setup, the program given the UART, miniterm on the same port - the port must not be reo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
2026-10-18 RESPIN.md: the precheck passes on rc4's slot-free GDS too
2026-10-18 rc4 promoted (Ken, 2026-10-18): gds/, lef/, pnl/ are runs/macro-rc4-art's results - rc3's RTL, Ken's calvin in the upper-right corner, a free draw (790K um of wire against rc3's 913K), Magic DRC / LV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
2026-10-18 RESPIN 21: a quad read of a flash floated the mode bits (Ken, 2026-10-18: quad on both selects as the FPGA's default, and the fix in the RTL, not a pull-up the chip will not have). lisa_qqspi.v float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
2026-10-18 fpga/arty_a7: arty_run.py ends its capture at the first of STOP's markers (ALL PASSED / SOME FAILED unless set) and prints the program's time from the UART hand-over - the seconds of a run were the l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
2026-10-18 rc6 promoted (Ken, 2026-10-18): gds/, lef/, pnl/ are runs/macro-rc6's results - the bank-register RTL (RESPIN 22) with Ken's calvin art, a free draw: clean, precheck passed, 824K um of wire, +1.5% sy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
2026-10-18 RESPIN 14 / 23: the UART receive FIFO's overrun flag in the status (Ken, 2026-10-18, for an interrupt-driven receiver) - bit 2 of 0x11 (the console UART's receiver in debug_ctrl.v) and bit 3 of 0x13 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
2026-10-18 rc7 promoted (Ken, 2026-10-18): gds/, lef/, pnl/ are runs/macro-rc7's results - rc6's RTL plus the UART receive overrun flag (RESPIN 14) and the read-strobe fix (RESPIN 23: a store no longer pops the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
2026-10-18 gds workflow: run on branch pushes again - the 'tags-ignore' alone of 44d110c made GitHub skip every push (a push filter that names only tags leaves the branches out), so no committed GDS had been pr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
2026-10-18 rc8 promoted (Ken, 2026-10-18): gds/, lef/, pnl/ are runs/macro-rc8's results - rc7's RTL with the 6-bit code bank (64 code banks, 2 MB of code), the calvin art, a free draw: clean, precheck passed, 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
2026-10-19 RESPIN 24: ldirq loaded nothing - its value in the misc-load case; the testbench's +TRACE instruction trace
    ldirq is a misc load (101000..): op_ld_misc_r came first in the
    acc_load_val case with no ldirq entry in acc_misc, so the op_ldirq_r item
    below was never reached and ldirq returned A unchanged. NuttX's restore
    (ldirq at the entry, stirq and rets at the exit) then brought amode 0 back
    from the first timer interrupt and the shell never started, on the Arty and
    on this testbench alike. The value is in the acc_misc case now:
    {amode_isr, signed_inv_live_isr, cflag_save_isr, signed_inv_isr, zflag_isr,
    cflag_isr}, the byte stirq takes back (item 6's set). Test:
    sdcc_test/test_ldirq (fails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
2026-10-19 RESPIN 25: the UART interrupt enables (0x14) had no write decode - TT07 too; the testbench types (SEND=) and logs the interrupt enables
    lisa_periph.v declared uart_rx_ie / uart_tx_ie, reset them, used them in the
    edge detectors of the interrupt bit and read them back at 0x14 - and never
    assigned them, on this chip and on TT07: no UART interrupt ever fired, and
    nothing noticed because every program polled. NuttX's shell printed its
    prompt and never saw a keystroke; the testbench's trace showed the driver
    writing 1 to the register once and every later read-modify-write starting
    from 0. A write to 0x14 loads the four enables now (bit 0 UART1 receive,
    1 UART1 transmit, 2 / 3 UART2); the reques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
2026-10-19 RESPIN 25: the UART interrupt requests are levels (Ken, 2026-10-18)
    INT_STATUS bit 2 (3 for UART2) is 'a byte waits and the receive interrupt is
    enabled, or the transmitter is empty and its interrupt is enabled' for as
    long as that holds: a byte already waiting when the enable is set interrupts
    at once, a second byte queued behind an unread one keeps the request up, the
    handler ends it by draining the FIFO, writing the next byte or dropping the
    enable, and a 1 written to the bit in INT_STATUS does nothing. The edge
    detectors and the two latched bits go (the write decode of the enables came
    in the commit before: until then no UART interrupt could fire at all). The
    other sources are instants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
2026-10-19 arty_a7/ttlc_io: the replies kept in step with the requests - a late reply made every other flash load fail
    A reply the bridge held back (seen as a 200 ms timeout on a status poll,
    then the retried poll answered with the first poll's reply) left the host
    one reply behind: the page-program command took the leftover 2-byte reply,
    the next poll took a status datagram, and 'the bridge does not hold the
    flash bus' was raised while its flags said it did. request() now drops
    whatever waits in the socket before a request, accepts a T reply only with
    exactly the transaction's byte count (a late reply to an earlier T is
    skipped), and treats a status answering a T with the bus still held as
    'busy, sen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
2026-10-19 RESPIN 26: lda (ix++) and the constant bank KB - constants packed two to a word, in any bank (Ken, 2026-10-18)
    A new instruction, 0xA14C (the misc slot after ldamode, whose decode was
    13 bits wide and took it; now the 14 the ISA gives it): from its exec
    state the core asks the instruction bus for the word at IX[14:1] with
    i_kfetch up, tt_um_lisa.v sends the fetch to bank KB (lisa_periph.v 0x1F,
    6 bits, reset 0 = the lower half), the exec state waits for the stream
    (k_ok in d_ok), A takes the byte IX[0] selects, Z follows it and IX gains
    one with its condition bit kept. KB does not carry when IX wraps: a
    constant stays inside its bank (32 KB of byte addresses). Why: NuttX's
    constants, an ld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
2026-10-19 rc10 promoted (Ken, 2026-10-18): gds/, lef/, pnl/ are runs/macro-rc10's results - rc8's RTL with items 24 (ldirq), 25 (the UART interrupt enables and level requests) and 26 (lda (ix++) with the const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
2026-10-19 RESPIN 27: the divider's second result in IX and the chained step divc; lisa_div.v a restoring divider
    lisa_div.v: one 17-bit subtractor, 16 clocks for a division (8 for a
    step), in place of the repeated subtraction with the divisor shifted by
    10 / 7 / 4 / 0 bits (10-95 clocks, four compare-and-subtract pairs).
    The dividend's magnitude shifts out of result (RA) into the remainder b
    (IX), the quotient shifts into result. Both results come out: div
    leaves the quotient in RA / A and the remainder in IX, rem the other way
    round (TT07 and rc10 cleared IX in s_done). The divisor's magnitude is
    latched in a; divc (0xA174, the misc slot after lddiv, op_chain) divides
    {IX, A} by it - the quotient b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
2026-10-19 rc11 promoted (Ken, 2026-10-19): gds/, lef/, pnl/ are runs/macro-rc11's results - rc10's RTL with item 27 (the restoring divider, the remainder in IX, the chained step divc), the calvin art, a free d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
2026-10-19 test: SEND_PROMPT='nsh> ' types SEND a line at a time, each after the prompt shows
    Typed at once, a shell keeps 63 characters (the chip's 8-byte FIFO, then
    the driver's 64-byte buffer) and waits forever for the rest of the line it
    was in the middle of: the banked NuttX run with eleven lines of SEND
    launched three of its five banktests and went quiet. With the prompt gate
    the same run passes: five background banktests over banks 1 and 2, ps,
    free, their exits and the memory back.
2026-10-20 REV3: the twenty-four-bit core - IX, SP, RA and IA 23 bits plus the condition bit, the pairs three stages, ldxf / txah / taxh, CB 7 bits carried by RA, IA and IX, the data space flat 8 MB
    lisa_core.v: D_BITS 23 (IX, SP, RA, IA, the address adders); a 2-bit stage
    for sra / lra / push ix / pop ix / stxx / ldxx (the low byte first at SP-1,
    the middle, then {cond, 22:16} at the lowest address; stxx / ldxx the top
    byte at n+2 first); ldxf #imm24 (0xA190, two literal words, the predicate
    held off while they pass, no interrupt between them); txah 0xA014, taxh
    0xA110; txau / taxu the middle byte without the condition bit; ldx #imm16
    loads the 16 bits as given with the bank 0 and the condition bit se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
2026-10-20 REV3: call ix / jmp ix with bank 0 in the pointer keep the current bank - the lower 16K words are in every bank's view, so a pointer to code there (a function pointer, a jump table loaded with ldx) r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
2026-10-20 fpga/arty_a7 for the third chip: the multicycle groups take the 24-bit registers (IX = the divider's b and ix_hi[6:0], its condition bit ix_hi[7]; RA = result[14:0] and ra_hi), the stream's hierarchy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
    Timing at 50 MHz: -2.7 ns on the 16 facc endpoints only - cond -> the fetch
    address -> the stream's window lookup -> inst -> fx[inst[1:0]] -> the BF16
    adder ->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
2026-10-20 lisa_core: the BF16 operations take their f-register index from inst_r - the adder cone into facc had a single-cycle path from cond that was never real
    fadd, fmul, fcmp, fswap and fneg selected fx[inst[1:0]] through the
    combinational instruction word. In their execute state the core requests
    no fetch (i_fetch is the fetch state or kfetch, the lda (ix++) constant
    read), so inst is inst_r there and the value is the same; but through inst
    the index hung off the stream's inst_i leg - the fetch address, the window
    lookup, the mux - and STA saw cond -> fetch address -> window lookup ->
    inst -> fx select -> operand classification -> BF16 adder -> facc as one
    cycle: 31 levels, two thirds of it rout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
2026-10-20 fpga/arty_a7/build.tcl: the timing-driven directives (place ExtraTimingOpt, phys_opt AggressiveExplore before and after route Explore) - with the inst_r change the 50 MHz build was 0.27 ns short on o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
2026-10-20 lisa_div: ldx_stage_two_r reset - it never was, and rev 3's startup exposed it: the predicate update is gated by ~ldx_stage_two, which stayed X (random on silicon) until the first ldx wrote the flop;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
    CI's test action failed test_bringup and test_uart_burst since the
    twenty-four-bit core (ba74fc8): progs/hello.hex, loaded from the flash
    model, was the --rev2 image, so its first call returned into garbage and
    nothing printed. Rebuilt with --rev3 (the default stack 0x7f, in the
    128-byte RAM the cache-off tests use) it printed under Verilator but still
    not under icarus: a t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
2026-10-20 rc15 promoted (Ken, 2026-10-20): gds/, lef/, pnl/ are runs/macro-rc15's results - the third chip's RTL (REV3.md) with the BF16 operand index from inst_r and lisa_div's ldx_stage_two_r reset
    The twenty-four-bit chip hardened with the rc12 recipe (the macro flow, a
    free draw with the art): 62210 instances, placed at 69.7%, 898K um of
    wire, Magic DRC / LVS / antenna 0, hold +0.072, setup +5.57 nominal and
    -6.5 at the slow max corner (rc12 -5.9: the widened registers; rc13 on
    the first rev-3 RTL -8.2, rc14 with inst_r -7.1). The RTL passes the
    chip testbench's rev-3 suite (28/28), CI's test action and the Arty at
    50 MHz with the flat NuttX kernel. The precheck is the gds workflow's.
    macro.json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
2026-10-20 fpga/arty_a7/arty_dump.py: the third chip's 24-bit SP / RA / IX (lisa_pydb's readSP / readRA / readIX), the peripheral reads through periph=True, the idle stack at 0x7FFE80, the rev-3 frame layout in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
2026-10-22 Add the SPI master (RESPIN 29) and hardened GDS rc16, plus doc updates
    The SPI master (src/lisa_spi.v, peripheral 0x28-0x2B: DATA, CTRL, DIV,
    STATUS; DONE is interrupt source 7) on its own pins: mux 2 puts CS0 /
    SCLK / MOSI on uo[3] / uo[5] / uo[6] and mux 0 CS1 on uo[7]; in mux 3 it
    shares the TTLC's output data lines (MOSI / CS0 / CS1 on uo[0..2], SCLK on
    uo[7]) through an interlock: CLAIM is granted between TTLC I/O scans and a
    scan asked for while the SPI owns the pins waits. Tested by test/progs/spi.c
    (test_spi and test_spi_ttlc, SPIM=1) against two device models in tb.v.
    gds/, lef/, pnl/ are runs/macro-spi-free's (a free draw with the art):
    61852 instances, 70.5%, routing / Magic DRC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
2026-10-22 Rename the top module to tt_um_pettit_lisa (tt_um_lisa is taken on ttsky26d)
    src/tt_um_lisa.v -> src/tt_um_pettit_lisa.v and its module, info.yaml's
    top_module and source list, and every reference: the chip and core
    testbenches, the Arty build, the SDC files, the harden scripts and the
    docs. The TT07 design keeps its name (README, lisa-tools' demo-board
    selection).
    gds/, lef/, pnl/ are now tt_um_pettit_lisa.* from runs/macro-pettit, the
    rc16 recipe re-run under the new name: identical results (61852
    instances, 70.5%, routing / Magic DRC, LVS and antenna clean, hold +0.077,
    setup +5.59 nominal, -6.8 at the slow max corner). The default, SPIM and
    TTLC chip suites and the core testbench pass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
2026-10-23 fpga/arty_a7/arty_run.py: REGS=a=v,... writes more debug registers just before the run
    For the SPI master's pins (REGS=0x1b=0x2880: CS0 / SCLK / MOSI on uo[3] /
    [5] / [6]). With it lisa-tools' sdcc_test/hw_spiflash.c and
    hw_spiflash_wr.c pass on the Arty (an SST25VF064C on JB3 / JB5 / JB6 and
    JA0) with the RESPIN 29 bitstream (50 MHz, setup +0.037, hold +0.056).
2026-10-23 fpga/arty_a7/arty_term.py: REGS=a=v,... as arty_run.py - the debug registers written just before the run
    REGS=0x1b=0x2880 routes the SPI master to uo[3] / [5] / [6] for NuttX's
    arty:smartfs (the SST flash on JB3 / JB5 / JB6 and JA0) in a terminal
    session that stays open.
2026-10-24 rc17: the TTLC's I/O from the core (RESPIN 30) - gds/, lef/, pnl/ from runs/macro-ttlcio
    src/lisa_ttlcio.v at [p:0x2C-0x2E]: the TTLC's 139-bit I/O vector
    (ttlc_io.v read_values: outputs, inputs, storage, port_in, RR and the
    constants) as 18 bytes through an auto-incrementing index - read at any
    time on a read port of its own, so the ICU never sees it; the output and
    storage bytes writable, the ICU's write of a bit in the same clock winning
    that bit - and a scan the core starts (TCTRL START, BUSY, DONE, PEND,
    TTLC_WAIT, OWNED). With the ICU halted (its reset state) the 74HC595 /
    74HC165 chains are the core's 48 outputs and 48 inputs. Atomic updates
    with the ICU running use the SPI master's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
2026-10-24 rc18: the 5x4 tile, Calvin as placement blockages - gds/, lef/, pnl/ from runs/macro-rc18
    Ken moved the design to a 5x4 tile (856.52 x 511.36 um; info.yaml) for
    room to add features, and put his Calvin into the cell structure itself:
    his two-colour 73 x 74 drawing (harden/art/calvin_nocircle/source.png,
    png2pixels.py: black = blocked) as 1016 hard placement blockages, each
    pixel two standard-cell rows (5.44 um) by 12 sites (5.52 um), the picture
    403 x 403 um at (12.42, 97.92) left of the RAM32 - no cell of any kind on
    a pixel, the rows, rails and routing go on over them.
    harden/flow.py: Project.ArtPixels (odb_art_pixels.py) makes the blockages
    after the rows are cut; Project.ArtPixelTaps, a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
2026-10-24 RESPIN 31-33: the TTLC's storage to 64 bits, Timer 3 (PWM, input capture), a WS2812B LED string driver; make calvin
    31. The TTLC's internal storage doubled: bits 32-63 at I/O addresses
    160-191 (bits 0-31 stay at 96-127), the read vector 192 bits padded to
    256, the write decode one compare per range (it no longer aliases 224-255
    onto 96-127); bytes 20-23 of the core's view (lisa_ttlcio.v, TIDX 0-23).
    Test: progs/ttlc/ttlc_storage.asm, the loopback through both ranges (make
    TTLC=1 TTLC_IMAGE=progs/ttlc_storage_test.hex; test_ttlc_debug's step
    bound 120 -> 300), ttlcio.c checks 1, 0x0d, 0x0e.
    32. Timer 3 (src/lisa_timer3.v, 0x30-0x3F): 16 bits, an 8-bit prescaler,
    TOP, two compares driving PWM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
2026-10-24 rc19: RESPIN 31-33 hardened with the RAM32 at the tile's right - gds/, lef/, pnl/ from runs/macro-rc19
    The TTLC's storage at 64 bits, Timer 3 and the WS2812B driver (0fe2829)
    with Ken's updated Calvin (997 pixels), and the RAM32 moved two more
    stripe pitches right, to x 505.31 (13 x 38.87), as far as the 5x4 tile
    allows (harden/macro.json): the draw at 427.57 did not route well
    (runs/macro-rc19-ram427, stopped) and runs/macro-ws2812 left an antenna
    violation on a clock leaf.
    80612 instances, 62.3%, 230804 um2 of standard cells, 1200K um of wire,
    global-route overflow 412, routing DRC / Magic DRC / LVS / antenna 0, hold
    +0.073, setup +4.96 nominal and -8.3 at the slow max corner (the core's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
2026-10-24 test/progs/ws2812.c: ws_put in assembly, the bit period 74 clocks (1.5 us)
    The C put took longer than a pixel on the Arty (the QSPI fetch at clk/4):
    a naked 16-instruction ws_put writes the three bytes into the free half
    (ws_half) and sets its FULL bit; WS_TBIT 74 gives the loop a little more
    time per pixel. The testbench's decoder takes the longer bit as before.
2026-10-24 RESPIN 34: QSPI at clk/2 - a write burst's word boundaries, and a late read capture
    lisa_qqspi.v S6: on a write, the word's first bit (nibble) goes on the pins
    in S6. After S7 SCLK is low and the transfer's first clock is its rising
    edge, so at clk/2 the first nibble of every later word in a burst changed
    on the edge the part samples it: the Arty's PSRAM took a bit-by-bit mix of
    it and the last nibble of the word before, and the data cache at clk/2
    failed (clk/4's divider clock hid it). Found with the PSRAM written and
    read from the debugger, the core halted.
    0x1E [14:13] (debug_regs.v, per select): rd_late - a read bit is taken
    again on the falling edge after the rising one that shifted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
2026-10-25 RESPIN 35: the WS2812B driver's DMA - frames from the PSRAM through the TTLC's fetch
    Ken's idea: in WS mode the MC14500B is halted, so the output flops hold a
    frame description instead of pixels - BASE (bytes 0-1, the buffer's data
    address / 256) and LEN (bytes 2-3, pixels [12:0]) - and the driver fetches
    the frame through the TTLC's instruction fetch, whose group of three words
    is two pixels: group A is sent while B is prefetched.
    lisa_ws2812.v: WS_CTRL [5] DMA, [6] REPEAT; WS_STAT bit 6 START / ACTIVE,
    bit 7 FRAME (sticky, the request with IE). START flushes the data cache
    (the debugger's flush, ORed in), waits for the fetch to be idle, restarts
    it at group 0 and sends; after each group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
2026-10-25 RESPIN 35 on the Arty: 200-pixel DMA frames at the datasheet's bit, no underrun at clk/2 or clk/4, the core thrashing the cache or not; wsdma.c's thrash check is "the core ran"
2026-10-25 rc21: RESPIN 34-35 hardened - gds/, lef/, pnl/ from runs/macro-rc21
    The QSPI at clk/2 (a write burst's word boundaries, the late read capture,
    4c8e126) and the WS2812B driver's DMA with the data cache's flush fix
    (ad8693c), on rc19's recipe (the 5x4 tile, the RAM32 at x 505.31, Calvin's
    997 pixels).
    80365 instances, 62.9%, 233220 um2 of standard cells, 1221K um of wire,
    global-route overflow 461, routing DRC / Magic DRC / LVS / antenna 0, hold
    +0.056, setup +5.51 nominal and -7.7 at the slow max corner (the core's
    exec_state, as rc19). No cell on Calvin's pixels. rc20 (RESPIN 34 alone)
    left one antenna violation and was not promoted.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
2026-10-25 RESPIN 35: the WS2812B DMA drives a real NeoPixel Jewel on the Arty (sdcc_test/hw_leddemo.c)
2026-10-25 io mux mode 3 and the I2C master: the custom Pmod's CE latch in tb.v and on the Arty (m3_pmod.v), an I2C slave in tb.v, I2C on JD
    test/tb.v: m3 - the custom Pmod's 7475 (transparent while uio[0] strobes,
    CE0 / CE1 from uio[1] / uio[2], the chip's drive kept from the parts
    meanwhile), the open-drain I2C bus on uio[4] / uio[5] and a write-only
    slave at 0x3C (bytes, hash, transactions, NAKed addresses). lisa.py
    setup(m3=True): 0x1c = 0x00fa. make M3=1 runs any program in mode 3
    (test_core with the cache passes); make I2C=1: progs/i2c.c - a NAKed
    probe, an SSD1309 init and a data transaction at 400 kHz, byte-exact.
    fpga/arty_a7/m3_pmod.v (SW2 up): the same Pmod as board logic - an LDPE
    latch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
2026-10-25 RESPIN 36: a 32-bit cycle counter, a watchdog and two PDM outputs
    lisa_cyccnt.v (0x48-0x4B): a count of clocks; a CYC0 read latches the
    upper bytes, a write clears it.
    lisa_wdt.v (0x4C-0x4F): kicked with 0xA5 within (TIMEOUT + 1) x
    2^(16 + SCALE) clocks or it resets the core (ORed into the debugger's core
    reset) and the peripherals (lisa_periph.v's rst_n ANDed with it) - not
    itself (rst_por_n), the debug registers or the QSPI setup, so the program
    restarts from the flash. Then EN is clear and WDRST set.
    lisa_pdm.v (0x50-0x52): two first-order sigma-delta modulators, a density
    of VAL / 256, on Timer 3's PWM pins (uo[1] / uo[2], mux 2) when enabled -
    an 8-bit DAC through an RC filter.
    test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
2026-10-25 RESPIN 36: the PDM is a mode of Timer 3 (IE [6:5], per channel: PDM or input capture)
    CAPn[8:0] is the accumulator ({0,CAPn[7:0]} + CMPn[7:0], the carry is
    the output on the channel's PWM pin); lisa_pdm.v (0x50-0x52, 36 flops)
    removed - rc22 with it routed far worse than rc21 (79 violations at the
    25th detailed-route iteration against 6). PWM unchanged on a channel in
    capture mode. misc36 bench: PDM 25.00% / 75.00%; TIMER3 unchanged.
2026-10-26 rc22: RESPIN 36 hardened - gds/, lef/, pnl/ from runs/macro-rc22
    The cycle counter, the watchdog and Timer 3's PDM mode (808b433,
    fac19e6) on rc21's recipe, with the global- and detailed-route antenna
    repair at 5 iterations (macro.json; 3 left one met3 net at ratio 1.02).
    79447 instances, 64.3%, 239441 um2 of standard cells, 1227K um of wire,
    global-route overflow 534, routing DRC / Magic DRC / LVS / antenna 0, hold
    +0.079, setup +4.36 nominal and -6.6 at the slow max corner. No cell on
    Calvin's pixels.
2026-10-26 rc23: RESPIN 37 hardened - gds/, lef/, pnl/ from runs/macro-rc23
    The DDR instruction reads (a81e5fb) on rc22's recipe. 79368 instances,
    64.6%, 240735 um2 of standard cells, 1244K um of wire, global-route
    overflow 830, routing DRC / Magic DRC / LVS / antenna 0, hold +0.076,
    setup +5.24 nominal and -8.7 at the slow max corner (op_ldk_r -> k_ok ->
    d_ok, as rc22's -6.6; nothing in the QSPI). No cell on Calvin's pixels.
2026-10-26 rc27: RESPIN 38 hardened - gds/, lef/, pnl/ from runs/macro-rc27
    The slow corner (95fcac2) on rc23's recipe: 79242 instances, 64.7%, 1247K
    um of wire, routing DRC / Magic DRC / LVS / antenna 0, hold +0.079, setup
    +5.25 nominal, -1.41 at the slow max corner (rc23 -8.74), -0.43 nom_ss,
    +0.73 min_ss. No cell on Calvin's pixels.
2026-10-26 RESPIN 38: lisa.sdc - the divider's second-stage flags and the decoded op_*_r flags to core3 two clocks (rc28 -0.49, rc29 -0.44 at the slow max corner, nom_ss / min_ss clean)
    lddiv / div / rem_stage_two are set as a two-word divide's first word ends
    and held through the second word's fetch, predecode and decode; op_*_r
    are registered every clock from inst, which changes only as a fetch (or
    lda (ix++)'s constant fetch) ends. Neither changes in the clock before a
    write of the registers written at an instruction's end. Left: stage ->
    the ldxx / stxx n(sp) offset -> d_addr_good -> d_ok -> ra, a real path.
2026-10-26 rc29: RESPIN 38 hardened - gds/, lef/, pnl/ from runs/macro-rc29
    The slow corner (95fcac2, e70f45a) on rc23's recipe: 79244 instances,
    64.7%, 1248K um of wire, routing DRC / Magic DRC / LVS / antenna 0, hold
    +0.073, setup +5.23 nominal, +0.48 nom_ss, +1.49 min_ss, -0.44 at the slow
    max corner on one path (stage -> d_ok -> ra; rc23 -8.74 on 183). No cell
    on Calvin's pixels.
2026-10-27 RESPIN 39: mode 3's CE latch strobe a clock wide, the CE values held half a clock past it (20 ns pulse and setup, 10 ns hold at 50 MHz; no clock added)
    The custom Pmod's latch (Ken's TT07 board: two 74LVC1G373) had half a clock
    of pulse, setup and hold - 10 ns each at 50 MHz, tight for the TT mux and
    pads. ce_latch alone is the strobe (one compare against a rising-edge
    copy, no glitch); ce_hold, its falling-edge copy, keeps CE0 / CE1 on
    uio[1] / uio[2] to the falling edge after it; the first command bit still
    leads SCLK's first rising edge by half a clock.
    tb.v measures the latch timing at the pins, test_i2c checks it against a
    74LVC1G373: 10 / 10 / 10 ns before, 20 / 10 / 20 after. The R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
2026-10-27 rc30: RESPIN 39 hardened - gds/, lef/, pnl/ from runs/macro-rc30 (the final run)
    Mode 3's clock-wide CE latch strobe (a1a9f9c) on rc23's recipe: 79464
    instances, 64.6%, 1236K um of wire, routing DRC / Magic DRC / LVS /
    antenna 0, hold +0.056, setup +4.87 nominal, +1.47 nom_ss, +1.96 min_ss,
    +0.68 at the slow max corner - every corner clean. No cell on Calvin's
    pixels. Ken: the final run, nothing more planned.
